sstallion/apple-mini/eagle/apple-mini.bmp

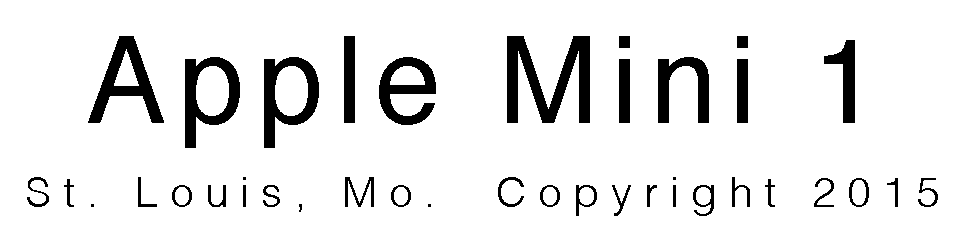
eagle/apple-mini.bmp
