sstallion/apple-mini/eagle/apple-mini.brd

## EAGLE design eagle/apple-mini.brd (2015-09-26)

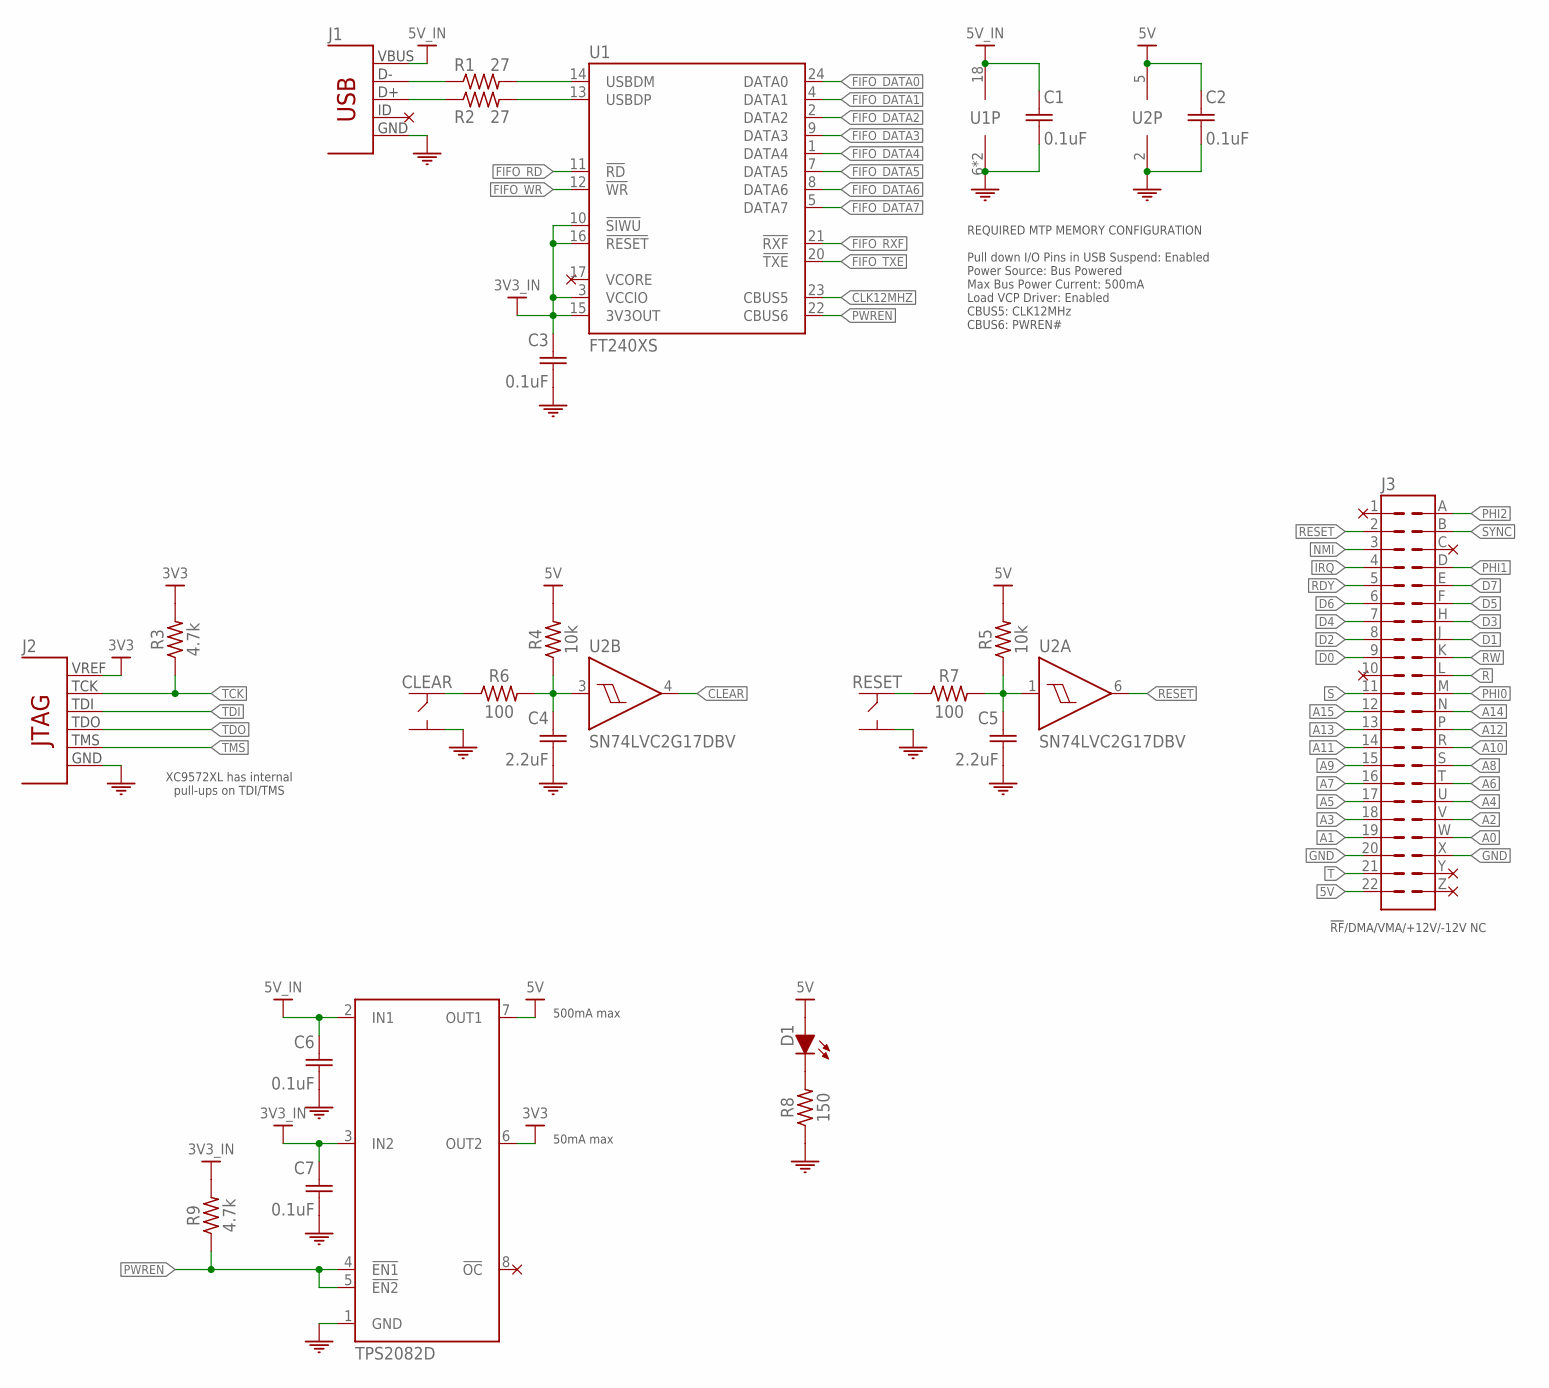
[picture p7: schematic apple-mini.sch, sheet 1, <b>I/O &amp; Supply</b>]

Parts:
C1, C2, C3, C6, C7: 0.1uF; 0603; MFR_PARTNO C0603C104K4RACTU
C4, C5: 2.2uF; 0603; MFR_PARTNO C0603C225K4PACTU
CLEAR: TACTSW; SMTR92
D1: CHIPLED; 0603; MFR_PARTNO LTST-C190KGKT
J1: USBMICRO; 10118193-0001LF
J2: JTAG; PH07-2-SMT
J3: RBM22DRTN; M22DRTN
R1, R2: 27; 0402; MFR_PARTNO RC0402JR-0727RL
R3, R9: 4.7k; 0603; MFR_PARTNO RC0603JR-074K7L
R4, R5: 10k; 0603; MFR_PARTNO RC0603JR-0710KL
R6, R7: 100; 0603; MFR_PARTNO ESR03EZPJ101
R8: 150; 0603; MFR_PARTNO ESR03EZPJ181
RESET: TACTSW; SMTR92
U1: FT240XS; SSOP24
U2: SN74LVC2G17DBV; SOT23-6
U3: TPS2082D; SOIC8

Connections:
3V3: J2.2 (VREF), R3.2, U3.6 (OUT2); also elsewhere on the board
3V3_IN: C3.1, C7.1, R9.2, U1.3 (VCCIO), U1.10 (!SIWU), U1.15 (3V3OUT), U1.16 (!RESET), U3.3 (IN2)
5V: C2.1, D1.2, J3.22, R4.2, R5.2, U2.5 (VCC), U3.7 (OUT1); also elsewhere on the board
5V_IN: C1.1, C6.1, J1.1, U1.18 (VCC), U3.2 (IN1)
A0: J3.W; also elsewhere on the board
A1: J3.19; also elsewhere on the board
A2: J3.V; also elsewhere on the board
A3: J3.18; also elsewhere on the board
A4: J3.U; also elsewhere on the board
A5: J3.17; also elsewhere on the board
A6: J3.T; also elsewhere on the board
A7: J3.16; also elsewhere on the board
A8: J3.S; also elsewhere on the board
A9: J3.15; also elsewhere on the board
A10: J3.R; also elsewhere on the board
A11: J3.14; also elsewhere on the board
A12: J3.P; also elsewhere on the board
A13: J3.13; also elsewhere on the board
A14: J3.N; also elsewhere on the board
A15: J3.12; also elsewhere on the board
CLEAR: U2.4 (Y); also elsewhere on the board
CLK12MHZ: U1.23 (CBUS5); also elsewhere on the board
D0: J3.9; also elsewhere on the board
D1: J3.J; also elsewhere on the board
D2: J3.8; also elsewhere on the board
D3: J3.H; also elsewhere on the board
D4: J3.7; also elsewhere on the board
D5: J3.F; also elsewhere on the board
D6: J3.6; also elsewhere on the board
D7: J3.E; also elsewhere on the board
FIFO_DATA0: U1.24 (DATA0); also elsewhere on the board
FIFO_DATA1: U1.4 (DATA1); also elsewhere on the board
FIFO_DATA2: U1.2 (DATA2); also elsewhere on the board
FIFO_DATA3: U1.9 (DATA3); also elsewhere on the board
FIFO_DATA4: U1.1 (DATA4); also elsewhere on the board
FIFO_DATA5: U1.7 (DATA5); also elsewhere on the board
FIFO_DATA6: U1.8 (DATA6); also elsewhere on the board
FIFO_DATA7: U1.5 (DATA7); also elsewhere on the board
FIFO_RD: U1.11 (!RD); also elsewhere on the board
FIFO_RXF: U1.21 (!RXF); also elsewhere on the board
FIFO_TXE: U1.20 (!TXE); also elsewhere on the board
FIFO_WR: U1.12 (!WR); also elsewhere on the board
GND: C1.2, C2.2, C3.2, C4.2, C5.2, C6.2, C7.2, CLEAR.3 (2), CLEAR.4 (2), J1.5, J1.6 (5), J1.7 (5), J1.8 (5), J1.9 (5), J2.3 (GND), J2.5 (GND), J2.7 (GND), J2.9 (GND), J2.11 (GND), J3.20, J3.X, R8.1, RESET.3 (2), RESET.4 (2), U1.6 (GND), U1.19 (GND), U2.2 (GND), U3.1 (GND); also elsewhere on the board
IRQ: J3.4; also elsewhere on the board
unnamed: D1.1, R8.2
unnamed: J1.2, R1.1
unnamed: J1.3, R2.1
unnamed: CLEAR.1, CLEAR.2 (1), R6.1
unnamed: R1.2, U1.14 (USBDM)
unnamed: R2.2, U1.13 (USBDP)
unnamed: R7.1, RESET.1, RESET.2 (1)
unnamed: C4.1, R4.1, R6.2, U2.3 (A)
unnamed: C5.1, R5.1, R7.2, U2.1 (A)
NMI: J3.3; also elsewhere on the board
PHI0: J3.M; also elsewhere on the board
PHI1: J3.D; also elsewhere on the board
PHI2: J3.A; also elsewhere on the board
PWREN: R9.1, U1.22 (CBUS6), U3.4 (!EN1), U3.5 (!EN2)
R: J3.L; also elsewhere on the board
RDY: J3.5; also elsewhere on the board
RESET: J3.2, U2.6 (Y); also elsewhere on the board
RW: J3.K; also elsewhere on the board
S: J3.11; also elsewhere on the board
SYNC: J3.B; also elsewhere on the board
T: J3.21; also elsewhere on the board
TCK: J2.6 (TCK), R3.1; also elsewhere on the board
TDI: J2.10 (TDI); also elsewhere on the board
TDO: J2.8 (TDO); also elsewhere on the board
TMS: J2.4 (TMS); also elsewhere on the board
VCORE: U1.17 (VCORE)

Notes on the sheet:
XC9572XL has internal pull-ups on TDI/TMS
!RF!/DMA/VMA/+12V/-12V NC
REQUIRED MTP MEMORY CONFIGURATION Pull down I/O Pins in USB Suspend: Enabled Power Source: Bus Powered Max Bus Power Current: 500mA Load VCP Driver: Enabled CBUS5: CLK12MHz CBUS6: PWREN#
50mA max
500mA max

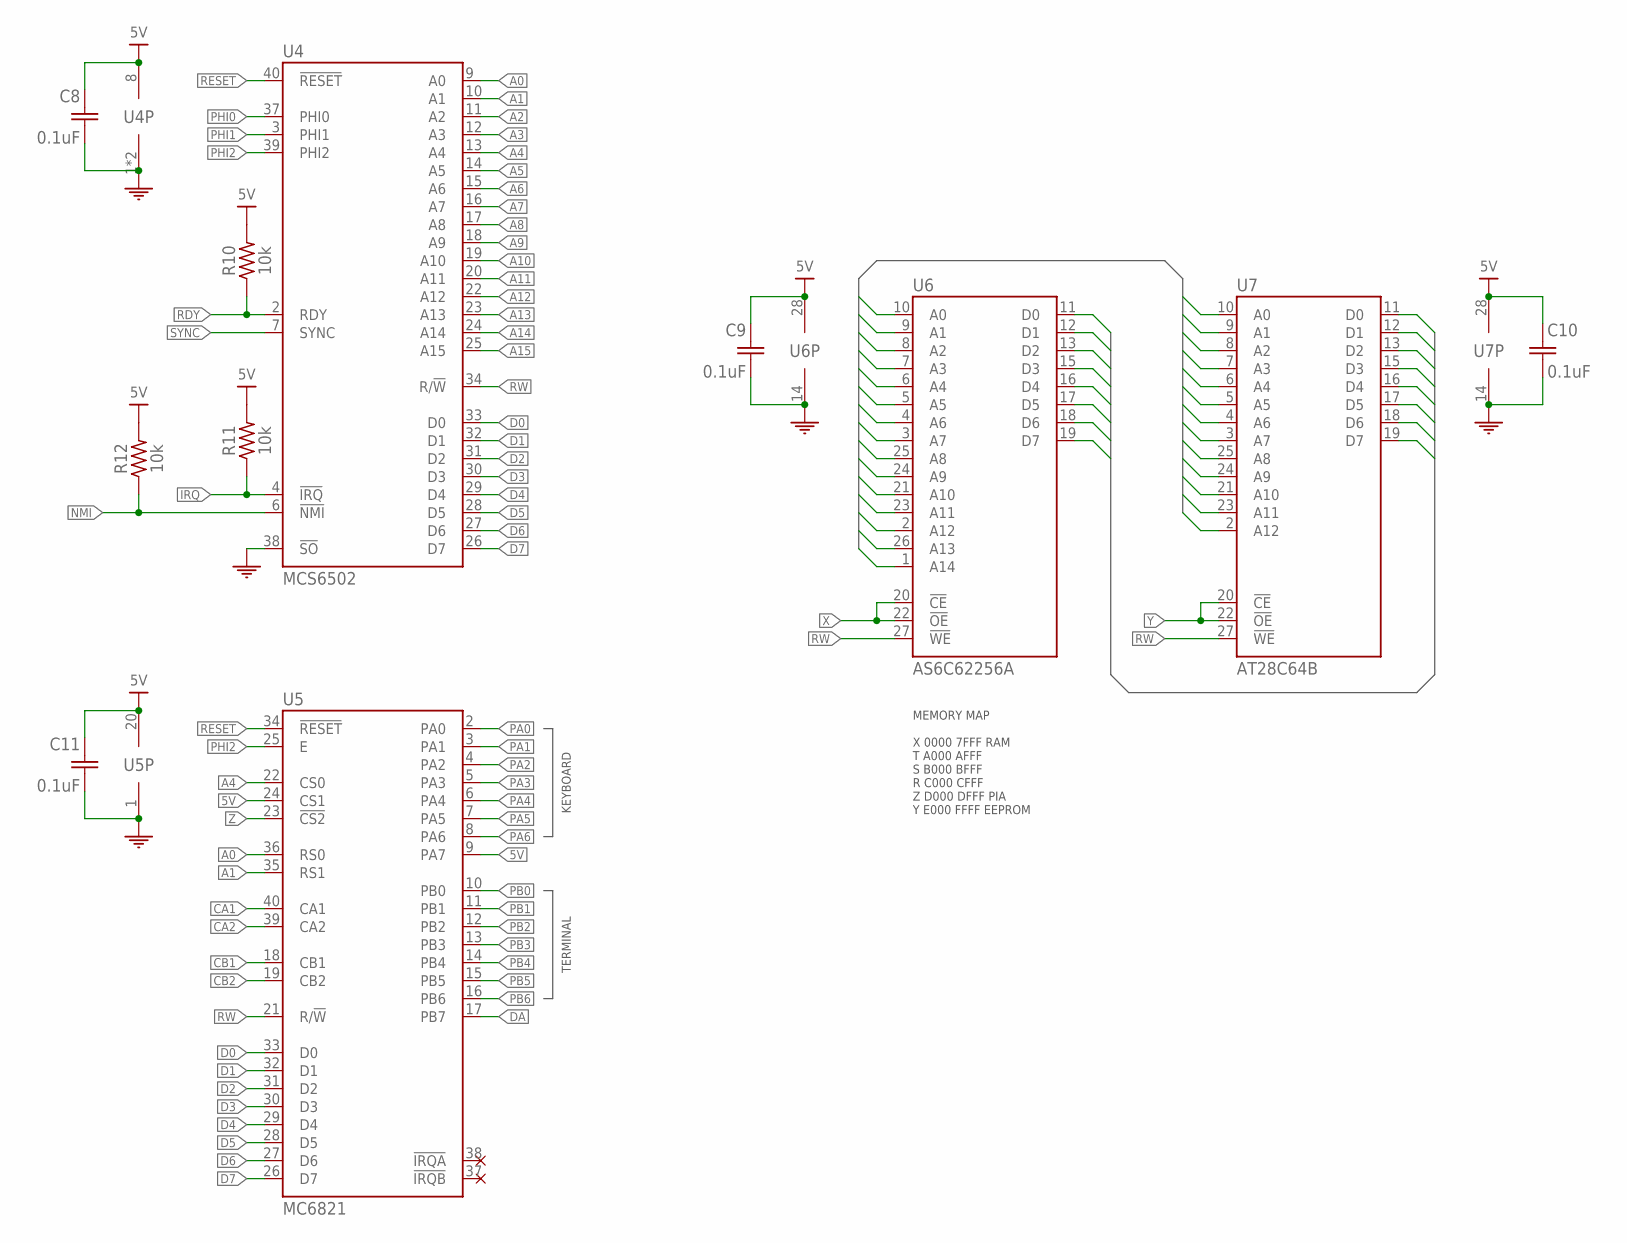
[picture p8: schematic apple-mini.sch, sheet 2, <b>MPU PIA &amp; Memory</b>]

Parts:
C8, C9, C10, C11: 0.1uF; 0603; MFR_PARTNO C0603C104K4RACTU
R10, R11, R12: 10k; 0603; MFR_PARTNO RC0603JR-0710KL
U4: MCS6502; DIP40
U5: MC6821; DIP40
U6: AS6C62256A; DIP28
U7: AT28C64B; DIP28

Connections:
5V: C8.1, C9.1, C10.1, C11.1, R10.2, R11.2, R12.2, U4.8 (VCC), U5.9 (PA7), U5.20 (VCC), U5.24 (CS1), U6.28 (VCC), U7.28 (VCC); also elsewhere on the board
A0: U4.9 (A0), U5.36 (RS0), U6.10 (A0), U7.10 (A0); also elsewhere on the board
A1: U4.10 (A1), U5.35 (RS1), U6.9 (A1), U7.9 (A1); also elsewhere on the board
A2: U4.11 (A2), U6.8 (A2), U7.8 (A2); also elsewhere on the board
A3: U4.12 (A3), U6.7 (A3), U7.7 (A3); also elsewhere on the board
A4: U4.13 (A4), U5.22 (CS0), U6.6 (A4), U7.6 (A4); also elsewhere on the board
A5: U4.14 (A5), U6.5 (A5), U7.5 (A5); also elsewhere on the board
A6: U4.15 (A6), U6.4 (A6), U7.4 (A6); also elsewhere on the board
A7: U4.16 (A7), U6.3 (A7), U7.3 (A7); also elsewhere on the board
A8: U4.17 (A8), U6.25 (A8), U7.25 (A8); also elsewhere on the board
A9: U4.18 (A9), U6.24 (A9), U7.24 (A9); also elsewhere on the board
A10: U4.19 (A10), U6.21 (A10), U7.21 (A10); also elsewhere on the board
A11: U4.20 (A11), U6.23 (A11), U7.23 (A11); also elsewhere on the board
A12: U4.22 (A12), U6.2 (A12), U7.2 (A12); also elsewhere on the board
A13: U4.23 (A13), U6.26 (A13); also elsewhere on the board
A14: U4.24 (A14), U6.1 (A14); also elsewhere on the board
A15: U4.25 (A15); also elsewhere on the board
CA1: U5.40 (CA1); also elsewhere on the board
CA2: U5.39 (CA2); also elsewhere on the board
CB1: U5.18 (CB1); also elsewhere on the board
CB2: U5.19 (CB2); also elsewhere on the board
D0: U4.33 (D0), U5.33 (D0), U6.11 (D0), U7.11 (D0); also elsewhere on the board
D1: U4.32 (D1), U5.32 (D1), U6.12 (D1), U7.12 (D1); also elsewhere on the board
D2: U4.31 (D2), U5.31 (D2), U6.13 (D2), U7.13 (D2); also elsewhere on the board
D3: U4.30 (D3), U5.30 (D3), U6.15 (D3), U7.15 (D3); also elsewhere on the board
D4: U4.29 (D4), U5.29 (D4), U6.16 (D4), U7.16 (D4); also elsewhere on the board
D5: U4.28 (D5), U5.28 (D5), U6.17 (D5), U7.17 (D5); also elsewhere on the board
D6: U4.27 (D6), U5.27 (D6), U6.18 (D6), U7.18 (D6); also elsewhere on the board
D7: U4.26 (D7), U5.26 (D7), U6.19 (D7), U7.19 (D7); also elsewhere on the board
DA: U5.17 (PB7); also elsewhere on the board
GND: C8.2, C9.2, C10.2, C11.2, U4.1 (GND), U4.21 (GND), U4.38 (!SO), U5.1 (GND), U6.14 (GND), U7.14 (GND); also elsewhere on the board
IRQ: R11.1, U4.4 (!IRQ); also elsewhere on the board
NMI: R12.1, U4.6 (!NMI); also elsewhere on the board
PA0: U5.2 (PA0); also elsewhere on the board
PA1: U5.3 (PA1); also elsewhere on the board
PA2: U5.4 (PA2); also elsewhere on the board
PA3: U5.5 (PA3); also elsewhere on the board
PA4: U5.6 (PA4); also elsewhere on the board
PA5: U5.7 (PA5); also elsewhere on the board
PA6: U5.8 (PA6); also elsewhere on the board
PB0: U5.10 (PB0); also elsewhere on the board
PB1: U5.11 (PB1); also elsewhere on the board
PB2: U5.12 (PB2); also elsewhere on the board
PB3: U5.13 (PB3); also elsewhere on the board
PB4: U5.14 (PB4); also elsewhere on the board
PB5: U5.15 (PB5); also elsewhere on the board
PB6: U5.16 (PB6); also elsewhere on the board
PHI0: U4.37 (PHI0); also elsewhere on the board
PHI1: U4.3 (PHI1); also elsewhere on the board
PHI2: U4.39 (PHI2), U5.25 (E); also elsewhere on the board
RDY: R10.1, U4.2 (RDY); also elsewhere on the board
RESET: U4.40 (!RESET), U5.34 (!RESET); also elsewhere on the board
RW: U4.34 (R/!W), U5.21 (R/!W), U6.27 (!WE), U7.27 (!WE); also elsewhere on the board
SYNC: U4.7 (SYNC); also elsewhere on the board
X: U6.20 (!CE), U6.22 (!OE); also elsewhere on the board
Y: U7.20 (!CE), U7.22 (!OE); also elsewhere on the board
Z: U5.23 (!CS2); also elsewhere on the board

Notes on the sheet:
MEMORY MAP X 0000 7FFF RAM T A000 AFFF S B000 BFFF R C000 CFFF Z D000 DFFF PIA Y E000 FFFF EEPROM
KEYBOARD
TERMINAL

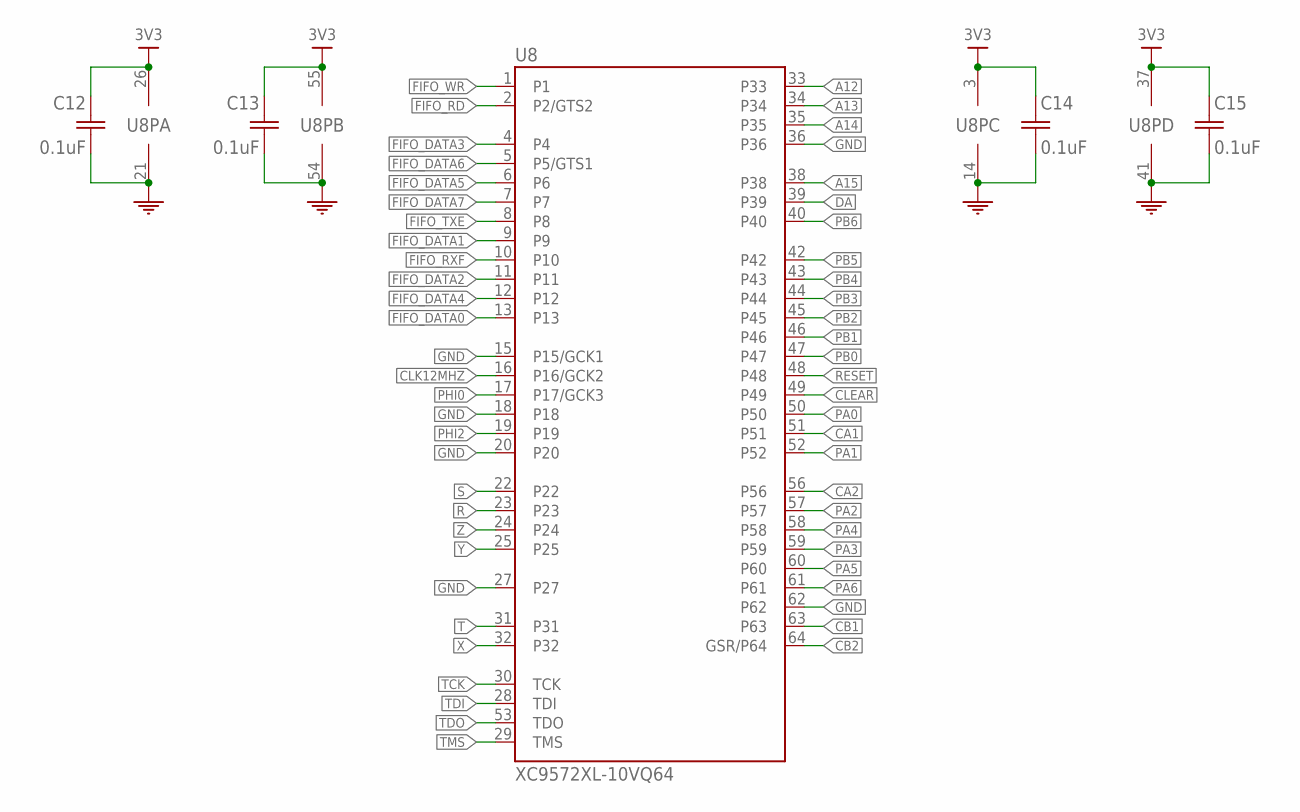
[picture p9: schematic apple-mini.sch, sheet 3, <b>CPLD</b>]

Parts:
C12, C13, C14, C15: 0.1uF; 0603; MFR_PARTNO C0603C104K4RACTU
U8: XC9572XL-10VQ64; VQFP64

Connections:
3V3: C12.1, C13.1, C14.1, C15.1, U8.3 (VCC), U8.26 (VCC), U8.37 (VCC), U8.55 (VCC); also elsewhere on the board
A12: U8.33; also elsewhere on the board
A13: U8.34; also elsewhere on the board
A14: U8.35; also elsewhere on the board
A15: U8.38; also elsewhere on the board
CA1: U8.51; also elsewhere on the board
CA2: U8.56; also elsewhere on the board
CB1: U8.63; also elsewhere on the board
CB2: U8.64 (GSR/P64); also elsewhere on the board
CLEAR: U8.49; also elsewhere on the board
CLK12MHZ: U8.16 (P16/GCK2); also elsewhere on the board
DA: U8.39; also elsewhere on the board
FIFO_DATA0: U8.13; also elsewhere on the board
FIFO_DATA1: U8.9; also elsewhere on the board
FIFO_DATA2: U8.11; also elsewhere on the board
FIFO_DATA3: U8.4; also elsewhere on the board
FIFO_DATA4: U8.12; also elsewhere on the board
FIFO_DATA5: U8.6; also elsewhere on the board
FIFO_DATA6: U8.5 (P5/GTS1); also elsewhere on the board
FIFO_DATA7: U8.7; also elsewhere on the board
FIFO_RD: U8.2 (P2/GTS2); also elsewhere on the board
FIFO_RXF: U8.10; also elsewhere on the board
FIFO_TXE: U8.8; also elsewhere on the board
FIFO_WR: U8.1; also elsewhere on the board
GND: C12.2, C13.2, C14.2, C15.2, U8.14 (GND), U8.15 (P15/GCK1), U8.18, U8.20, U8.21 (GND), U8.27, U8.36, U8.41 (GND), U8.54 (GND), U8.62; also elsewhere on the board
PA0: U8.50; also elsewhere on the board
PA1: U8.52; also elsewhere on the board
PA2: U8.57; also elsewhere on the board
PA3: U8.59; also elsewhere on the board
PA4: U8.58; also elsewhere on the board
PA5: U8.60; also elsewhere on the board
PA6: U8.61; also elsewhere on the board
PB0: U8.47; also elsewhere on the board
PB1: U8.46; also elsewhere on the board
PB2: U8.45; also elsewhere on the board
PB3: U8.44; also elsewhere on the board
PB4: U8.43; also elsewhere on the board
PB5: U8.42; also elsewhere on the board
PB6: U8.40; also elsewhere on the board
PHI0: U8.17 (P17/GCK3); also elsewhere on the board
PHI2: U8.19; also elsewhere on the board
R: U8.23; also elsewhere on the board
RESET: U8.48; also elsewhere on the board
S: U8.22; also elsewhere on the board
T: U8.31; also elsewhere on the board
TCK: U8.30 (TCK); also elsewhere on the board
TDI: U8.28 (TDI); also elsewhere on the board
TDO: U8.53 (TDO); also elsewhere on the board
TMS: U8.29 (TMS); also elsewhere on the board
X: U8.32; also elsewhere on the board
Y: U8.25; also elsewhere on the board
Z: U8.24; also elsewhere on the board

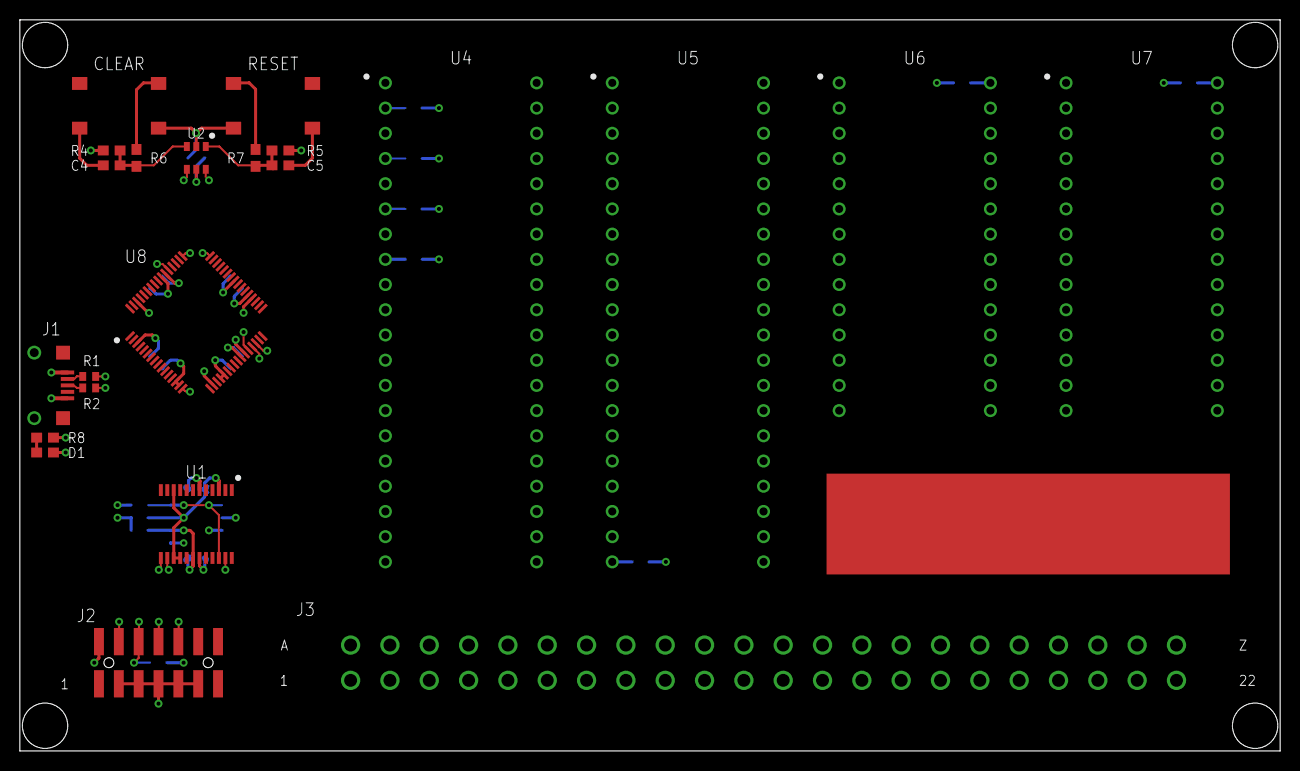
[picture p10: board apple-mini.brd from above]

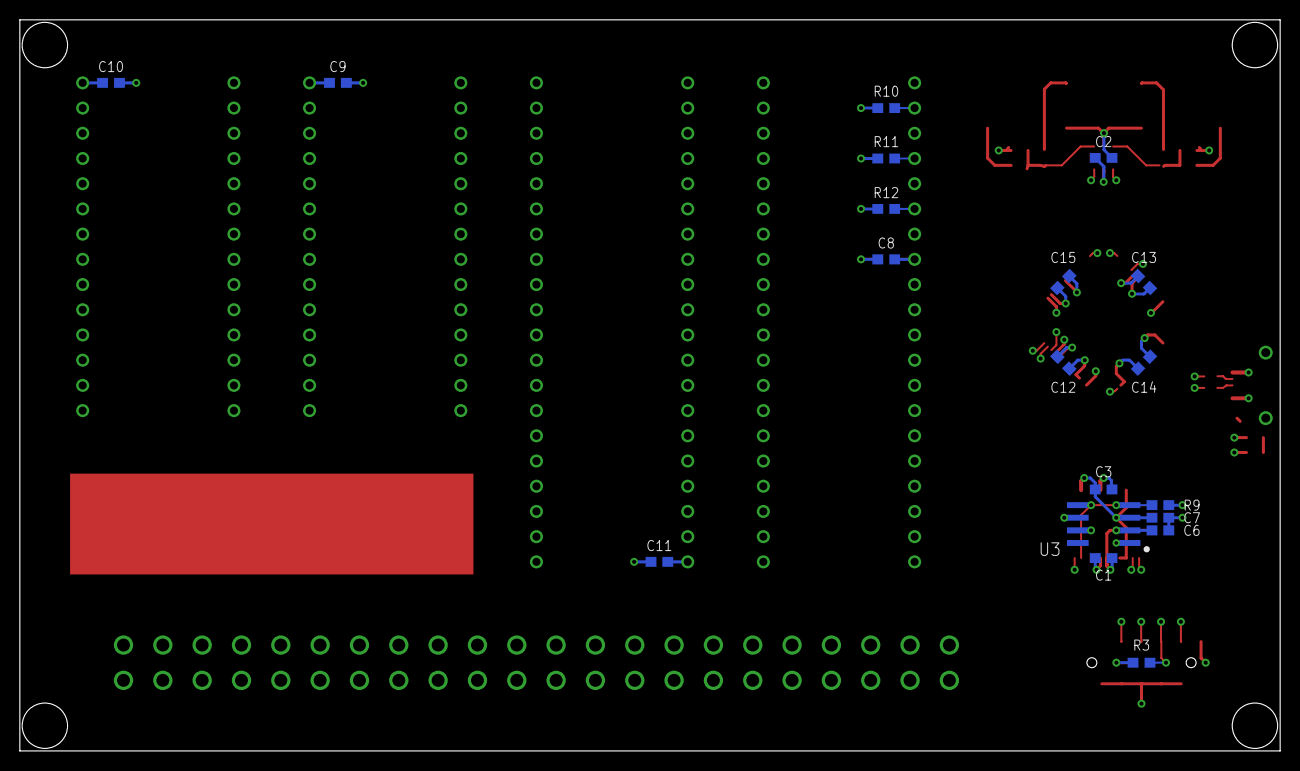
[picture p11: board apple-mini.brd from below]

Board: 4 copper layers, 127.0 x 73.7 mm, 41 parts (19 on the bottom side), 91 nets.
