sstallion/apple-mini/(commit log)

2015-07-10 Add multiple sheets; finalize FIFO and load switch
    [apple-idun.sch]
2015-07-10 Switch to synchronous CPLD design
2015-07-15 Cleanup; add PoR and JTAG
    [apple-idun.sch]
2015-07-15 Invert pia_cb2 input in pia_da assignment
    [fifo_mux.v]
2015-07-17 Rename project; sundry style updates
    [apple-mini.sch]
2015-07-17 Add remaining footprints
2015-07-19 Add CPLD and clear switch
    [apple-mini.sch]
2015-07-20 Add schmitt buffer on clear/reset
    [apple-mini.sch]
2015-07-21 Add MPU and PIA to schematic
    [apple-mini.sch]
2015-07-26 Finalize schematic; initial board placement
    [apple-mini.brd, apple-mini.sch]
2015-07-27 Add DRC rules and logo bitmap to board layout
    [apple-mini.brd, apple-mini.sch]
2015-07-28 Generate BOM
    [apple-mini.brd, apple-mini.sch]
2015-08-06 Route critical signals
    [apple-mini.brd, apple-mini.sch]
2015-08-23 Route power and remaining critical nets
    [apple-mini.brd, apple-mini.sch]
2015-09-26 Initial (and incomplete) gerbers
    [apple-mini.brd, apple-mini.sch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]
