sstallion/apple-mini/(notices)

Notices in the files:
parts and their libraries:
apple-mini: BY A BSD-STYLE LICENSE THAT CAN
